Sergey1560/ble2can_hw_v2/image/ble2can_v2.png

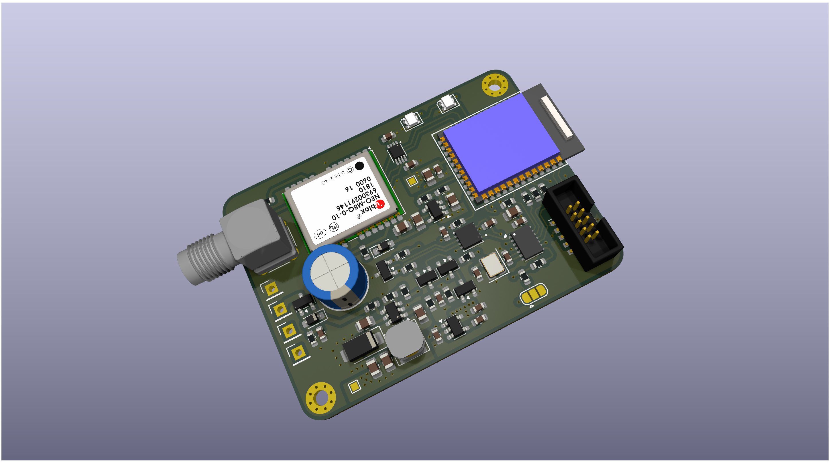
image/ble2can_v2.png
