Sergey1560/ble2can_hw_v2/image/board_size.png

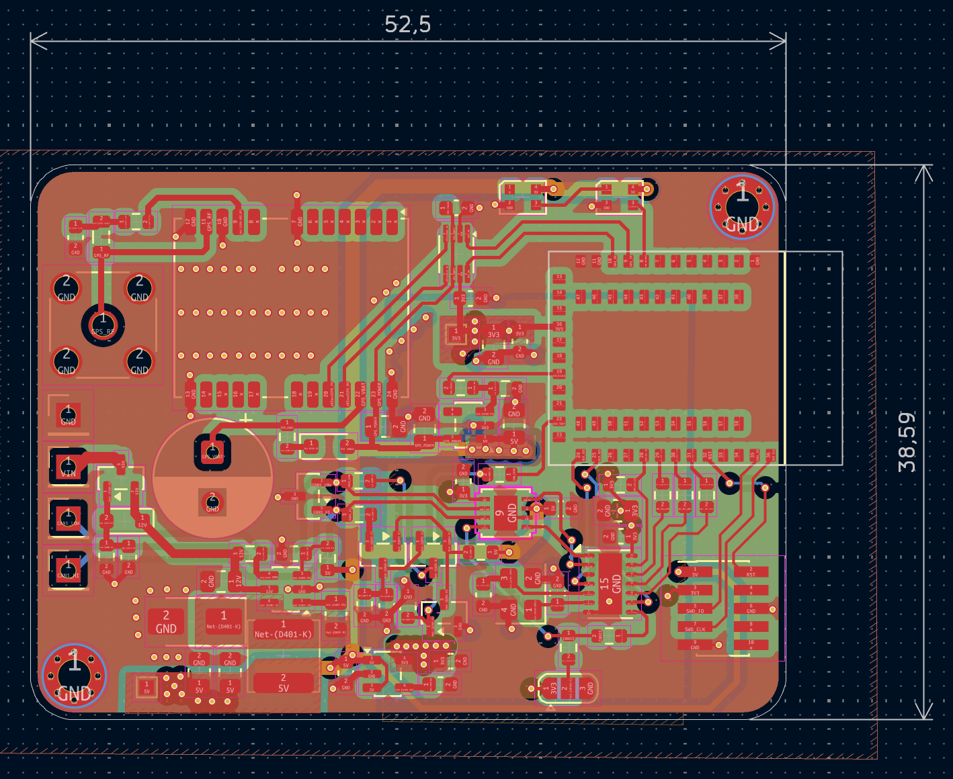
image/board_size.png
