Sergey1560/ble2can_hw_v2/3d/Led_WS2812B_2020.STEP

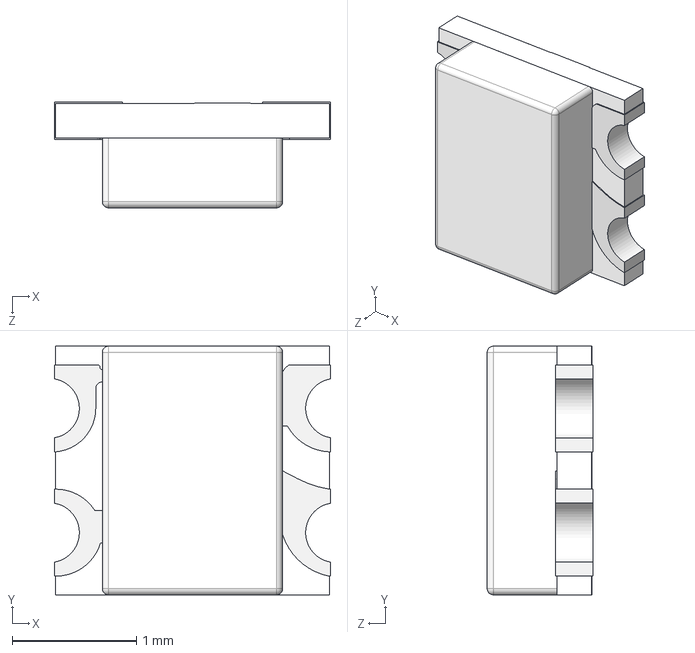
[picture p3: CAD file, 2025-12-26]
3d/Led_WS2812B_2020.STEP
2.22 x 2.00 x 0.85 mm
