Sergey1560/ble2can_hw_v2/3d/IDC2x05_SMD.STEP

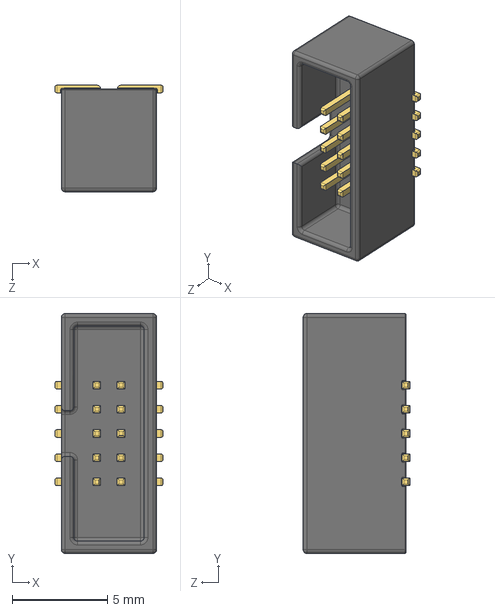
[picture p4: CAD file, 2025-12-24]
3d/IDC2x05_SMD.STEP
5.67 x 12.6 x 5.60 mm
