Sergey1560/ble2can_hw_v2/3d/SMA ANGLED.STEP

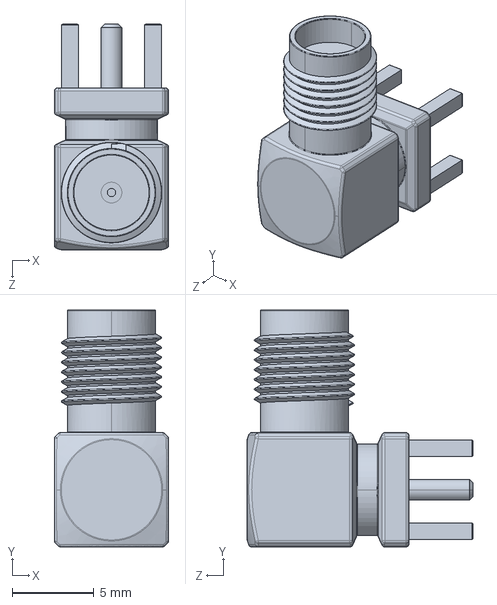
[picture p5: CAD file, 2025-12-24]
3d/SMA ANGLED.STEP
7.00 x 14.5 x 13.8 mm
