Sergey1560/ble2can_hw_v2/3d/holyiot_21069_nrf5340.STEP

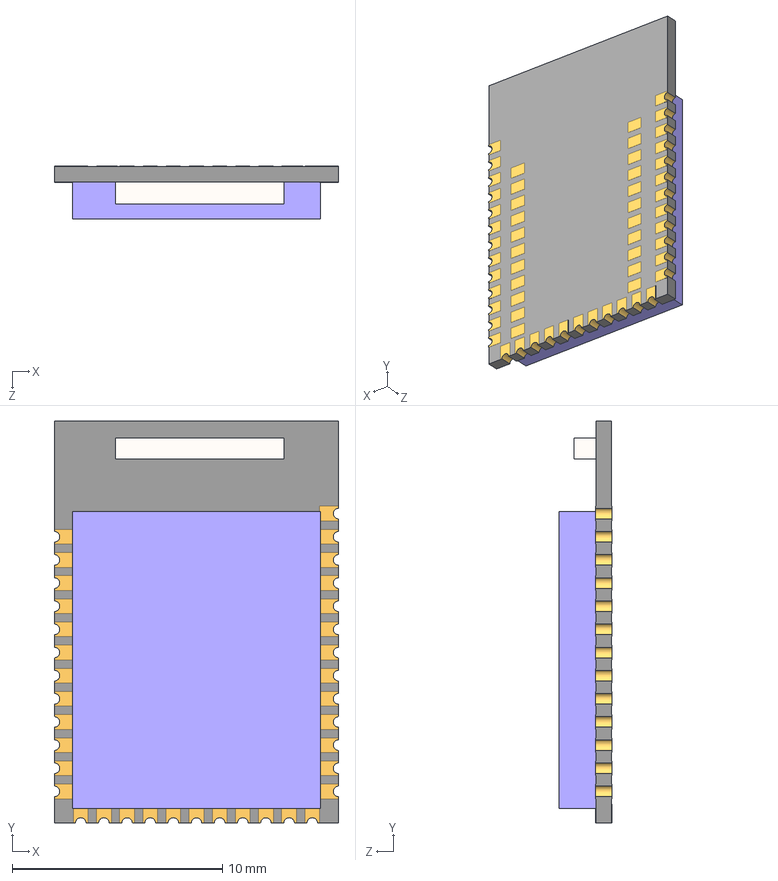
[picture p6: CAD file, 2025-08-31]
3d/holyiot_21069_nrf5340.STEP
13.5 x 19.1 x 2.51 mm
