Sergey1560/ble2can_hw_v2/rc_ble.kicad_pcb

## KiCad design rc_ble.kicad_pcb (2025-12-29)

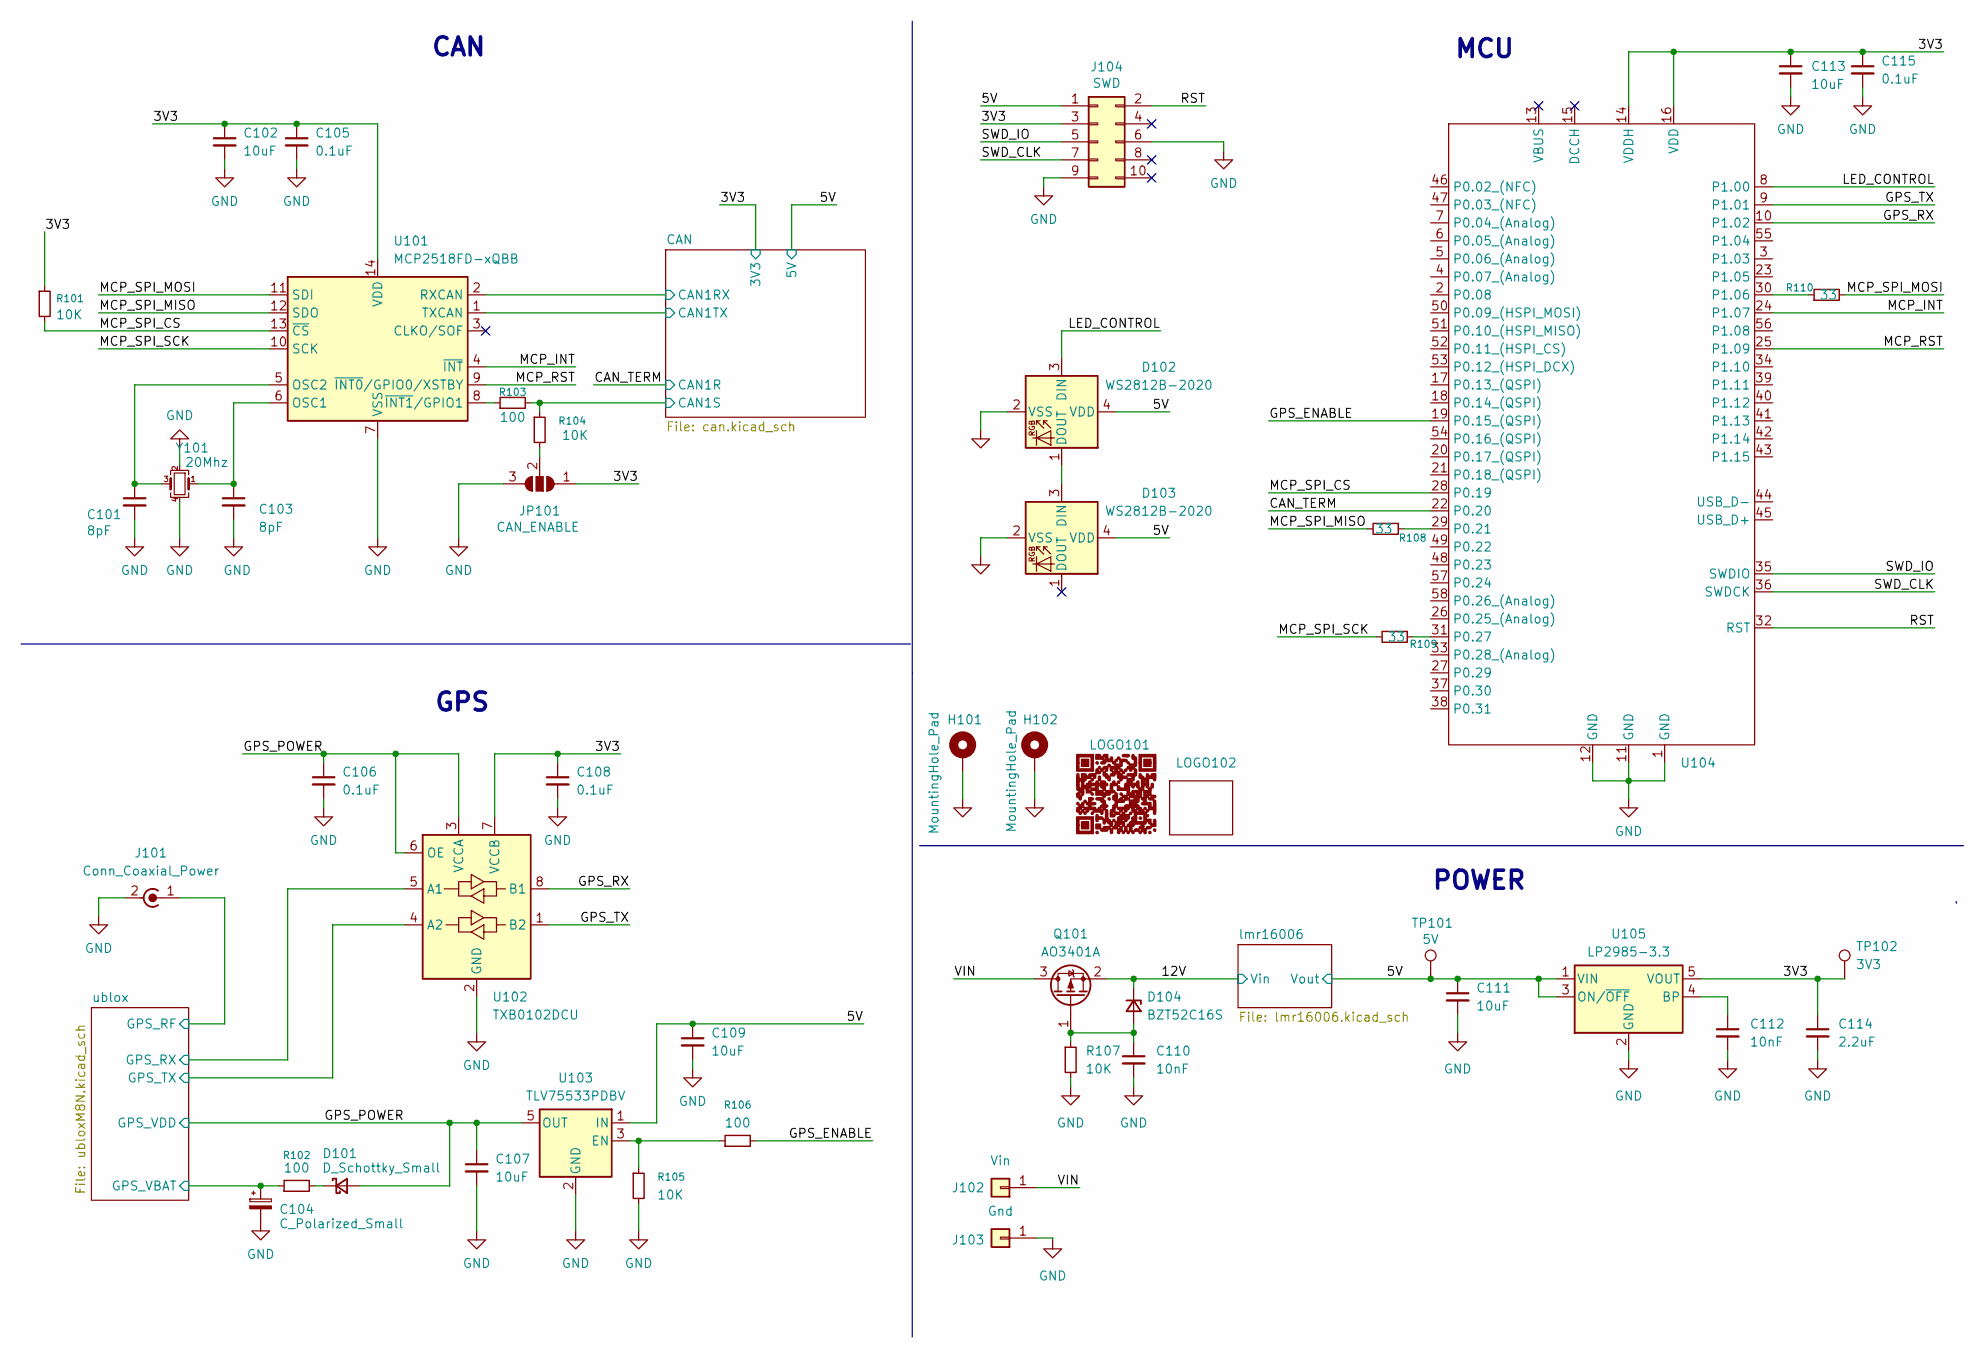
[picture p7: schematic rc_ble.kicad_sch]

Parts:
C101, C103: 8pF; C_0603_1608Metric; LCSC C38523
C102, C107, C109, C113: 10uF; C_0805_2012Metric
C104: C_Polarized_Small; CP_Radial_D8.0mm_P3.50mm
C105, C115: 0.1uF; C_0603_1608Metric
C106, C108: 0.1uF; C_0603_1608Metric; LCSC C14663
C110, C112: 10nF; C_0603_1608Metric; LCSC C57112
C111: 10uF; C_0603_1608Metric; LCSC C15849
C114: 2.2uF; C_0603_1608Metric; LCSC C23630
D101: D_Schottky_Small; D_SOD-323_HandSoldering
D102, D103: WS2812B-2020; LED_WS2812B-2020_PLCC4_2.0x2.0mm; LCSC C965555
D104: BZT52C16S; D_SOD-323_HandSoldering; LCSC C173447
H101, H102: MountingHole_Pad; MountingHole_2.2mm_M2_Pad_Via
J101: Conn_Coaxial_Power; SMA_Amphenol_132134_Vertical
J102: Vin; PinHeader_1x01_P2.54mm_Vertical
J103: Gnd; PinHeader_1x01_P2.54mm_Vertical
J104: SWD; PinHeader_2x05_P1.27mm_Vertical_SMD
JP101: CAN_ENABLE; SolderJumper-3_P1.3mm_Open_RoundedPad1.0x1.5mm
LOGO101: logo_github
LOGO102: logo_15x9
Q101: AO3401A; SOT-23; LCSC C15127
R101, R104, R105, R107: 10K; R_0603_1608Metric; LCSC C25804
R102, R103, R106: 100; R_0603_1608Metric
R108, R109, R110: 33; R_0603_1608Metric
TP101: 5V; TestPoint_Pad_1.0x1.0mm
TP102: 3V3; TestPoint_Pad_1.0x1.0mm
U101: MCP2518FD-xQBB; DFN-14-1EP_3x4.5mm_P0.65mm_EP1.65x4.25mm; LCSC C621395
U102: TXB0102DCU; VSSOP-8_2.3x2mm_P0.5mm; LCSC C60709
U103: TLV75533PDBV; SOT-23-5
U104: nrf5340
U105: LP2985-3.3; SOT-23-5; LCSC C95414
Y101: 20Mhz; Crystal_SMD_3225-4Pin_3.2x2.5mm

Connections:
/3V3: C102.1, C105.1, C108.1, C113.1, C114.1, C115.1, J104.3, JP101.1 (A), R101.1, TP102.1, U101.14 (VDD), U102.7 (VCCB), U104.14 (VDDH), U104.16 (VDD), U105.5 (VOUT); also elsewhere on the board
/5V: C109.1, C111.1, D102.4 (VDD), D103.4 (VDD), J104.1, TP101.1, U103.1 (IN), U105.1 (VIN), U105.3 (ON/~OFF); also elsewhere on the board
/12V: D104.1 (K), Q101.2 (S); also elsewhere on the board
/CAN/CAN1RX: U101.2 (RXCAN); also elsewhere on the board
/CAN/CAN1S: R103.2, R104.1; also elsewhere on the board
/CAN/CAN1TX: U101.1 (TXCAN); also elsewhere on the board
/CAN_TERM: U104.22 (P0.20); also elsewhere on the board
/GPS_ENABLE: R106.2, U104.19 (P0.15_(QSPI))
/GPS_POWER: C106.1, C107.1, D101.2 (A), U102.3 (VCCA), U102.6 (OE), U103.5 (OUT); also elsewhere on the board
/GPS_RX: U102.8 (B1), U104.10 (P1.02)
/GPS_TX: U102.1 (B2), U104.9 (P1.01)
/LED_CONTROL: D102.3 (DIN), U104.8 (P1.00)
/MCP_INT: U101.4 (~INT), U104.24 (P1.07)
/MCP_RST: U101.9 (~INT0/GPIO0/XSTBY), U104.25 (P1.09)
/MCP_SPI_CS: R101.2, U101.13 (~CS), U104.28 (P0.19)
/MCP_SPI_MISO: R108.2, U101.12 (SDO)
/MCP_SPI_MOSI: R110.2, U101.11 (SDI)
/MCP_SPI_SCK: R109.2, U101.10 (SCK)
/RST: J104.2, U104.32 (RST)
/SWD_CLK: J104.7, U104.36 (SWDCK)
/SWD_IO: J104.5, U104.35 (SWDIO)
/VIN: J102.1, Q101.3 (D)
/ublox/GPS_RF: J101.1 (In); also elsewhere on the board
/ublox/GPS_RX: U102.5 (A1); also elsewhere on the board
/ublox/GPS_TX: U102.4 (A2); also elsewhere on the board
/ublox/GPS_VBAT: C104.1, R102.1; also elsewhere on the board
GND: C101.2, C102.2, C103.2, C104.2, C105.2, C106.2, C107.2, C108.2, C109.2, C110.2, C111.2, C112.2, C113.2, C114.2, C115.2, D102.2 (VSS), D103.2 (VSS), H101.1, H102.1, J101.2 (Ext), J103.1, J104.6, J104.9, JP101.3 (B), R105.2, R107.2, U101.7 (VSS), U101.15 (VSS), U102.2 (GND), U103.2 (GND), U104.1 (GND), U104.11 (GND), U104.12 (GND), U105.2 (GND), Y101.2, Y101.4; also elsewhere on the board
unnamed: D101.1 (K), R102.2
unnamed: D102.1 (DOUT), D103.3 (DIN)
unnamed: C110.1, D104.2 (A), Q101.1 (G), R107.1
unnamed: JP101.2 (C), R104.2
unnamed: C103.1, U101.6 (OSC1), Y101.1
unnamed: C101.1, U101.5 (OSC2), Y101.3
unnamed: R103.1, U101.8 (~INT1/GPIO1)
unnamed: R105.1, R106.1, U103.3 (EN)
unnamed: R108.1, U104.29 (P0.21)
unnamed: R109.1, U104.31 (P0.27)
unnamed: R110.1, U104.30 (P1.06)
unnamed: C112.1, U105.4 (BP)

Notes on the sheet:
GPS
CAN
MCU
POWER

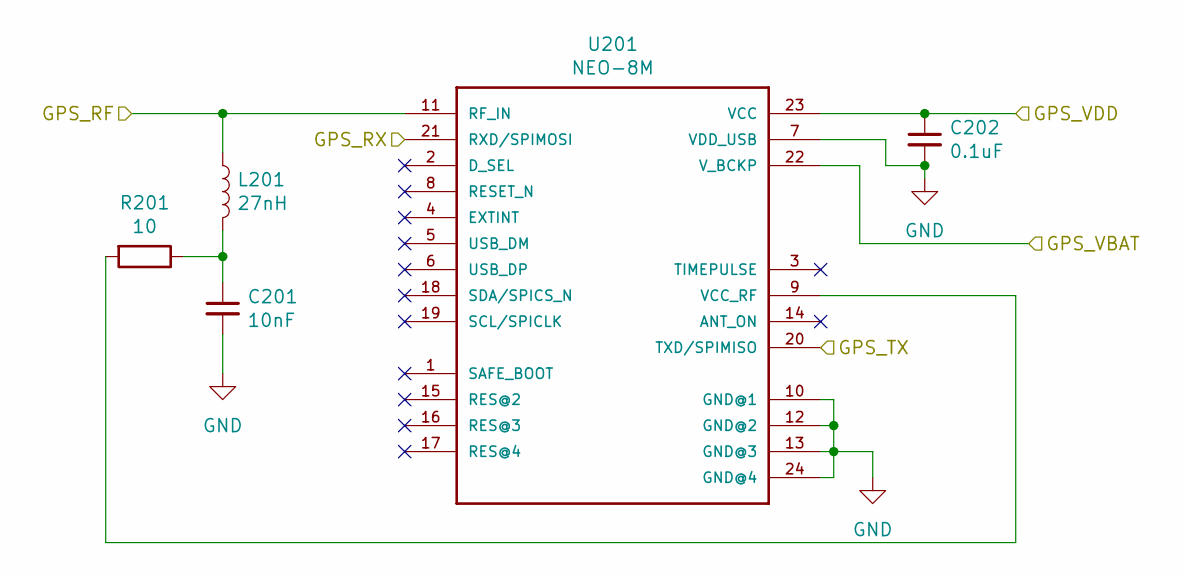
[picture p8: schematic ubloxM8N.kicad_sch, RC CAN and GPS BLE]

Parts:
C201: 10nF; C_0603_1608Metric
C202: 0.1uF; C_0805_2012Metric
L201: 27nH; L_0805_2012Metric
R201: 10; R_0603_1608Metric
U201: NEO-8M; ublox_NEO; LCSC C5119087

Connections:
/GPS_POWER: C202.1, U201.23 (VCC); also elsewhere on the board
/ublox/GPS_RF: L201.1, U201.11 (RF_IN); also elsewhere on the board
/ublox/GPS_RX: U201.21 (RXD/SPIMOSI); also elsewhere on the board
/ublox/GPS_TX: U201.20 (TXD/SPIMISO); also elsewhere on the board
/ublox/GPS_VBAT: U201.22 (V_BCKP); also elsewhere on the board
GND: C201.2, C202.2, U201.7 (VDD_USB), U201.10 (GND@1), U201.12 (GND@2), U201.13 (GND@3), U201.24 (GND@4); also elsewhere on the board
unnamed: C201.1, L201.2, R201.1
unnamed: R201.2, U201.9 (VCC_RF)

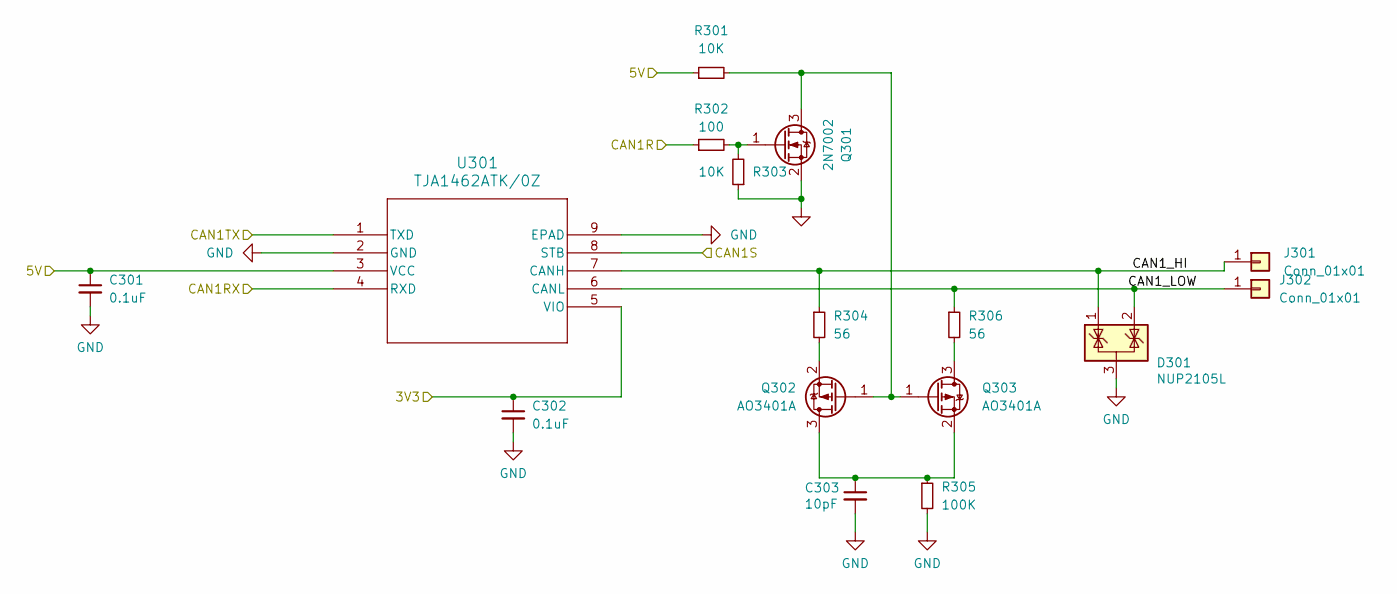
[picture p9: schematic can.kicad_sch, CAN BUS]

Parts:
C301, C302: 0.1uF; C_0603_1608Metric; LCSC C14663
C303: 10pF; C_0603_1608Metric; LCSC C1669
D301: NUP2105L; SOT-23; LCSC C284104
J301, J302: Conn_01x01; PinHeader_1x01_P2.54mm_Vertical
Q301: 2N7002; SOT-23; LCSC C8545
Q302, Q303: AO3401A; SOT-23; LCSC C15127
R301, R303: 10K; R_0603_1608Metric; LCSC C25804
R302: 100; R_0603_1608Metric; LCSC C22775
R304, R306: 56; R_0603_1608Metric; LCSC C25196
R305: 100K; R_0603_1608Metric; LCSC C25803
U301: TJA1462ATK/0Z; HVSON8_TJA1462_NXP; LCSC C3229259

Connections:
/3V3: C302.1, U301.5 (VIO); also elsewhere on the board
/5V: C301.1, R301.1, U301.3 (VCC); also elsewhere on the board
/CAN/CAN1RX: U301.4 (RXD); also elsewhere on the board
/CAN/CAN1S: U301.8 (STB); also elsewhere on the board
/CAN/CAN1TX: U301.1 (TXD); also elsewhere on the board
/CAN/CAN1_HI: D301.1 (K), J301.1, R304.1, U301.7 (CANH)
/CAN/CAN1_LOW: D301.2 (K), J302.1, R306.1, U301.6 (CANL)
/CAN_TERM: R302.1; also elsewhere on the board
GND: C301.2, C302.2, C303.2, D301.3 (A), Q301.2 (S), R303.1, R305.2, U301.2 (GND), U301.9 (EPAD); also elsewhere on the board
unnamed: Q301.3 (D), Q302.1 (G), Q303.1 (G), R301.2
unnamed: Q301.1 (G), R302.2, R303.2
unnamed: C303.1, Q302.3 (D), Q303.2 (S), R305.1
unnamed: Q302.2 (S), R304.2
unnamed: Q303.3 (D), R306.2

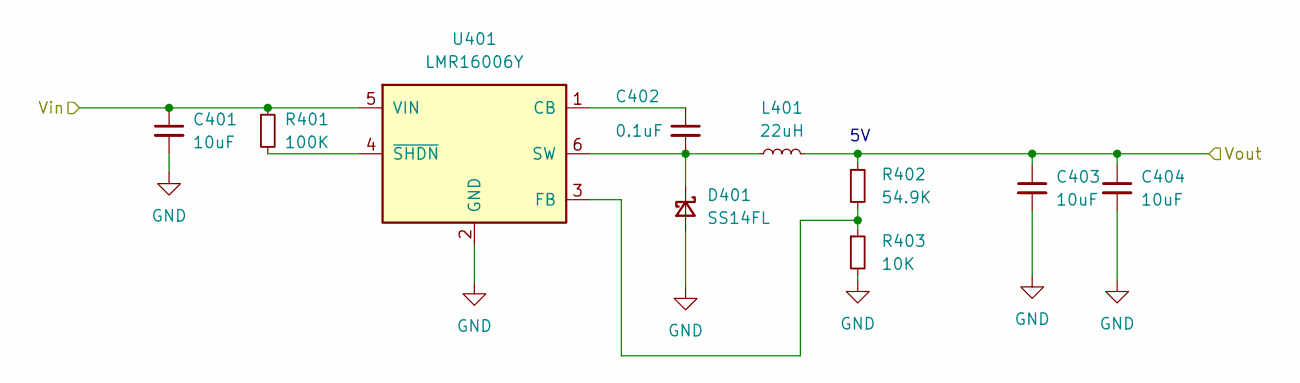
[picture p10: schematic lmr16006.kicad_sch, DC-DC]

Parts:
C401, C403, C404: 10uF; C_0805_2012Metric; LCSC C440198
C402: 0.1uF; C_0805_2012Metric; LCSC C28233
D401: SS14FL; D_SMA; LCSC C111580
L401: 22uH; FNR5040S220MT; LCSC C167971
R401: 100K; R_0603_1608Metric; LCSC C25803
R402: 54.9K; R_0603_1608Metric; LCSC C728593
R403: 10K; R_0603_1608Metric; LCSC C25804
U401: LMR16006Y; SOT-23-6; LCSC C290195

Connections:
/5V: C403.1, C404.1, L401.2, R402.1; also elsewhere on the board
/12V: C401.1, R401.1, U401.5 (VIN); also elsewhere on the board
GND: C401.2, C403.2, C404.2, D401.2 (A), R403.2, U401.2 (GND); also elsewhere on the board
unnamed: C402.2, D401.1 (K), L401.1, U401.6 (SW)
unnamed: C402.1, U401.1 (CB)
unnamed: R402.2, R403.1, U401.3 (FB)
unnamed: R401.2, U401.4 (~SHDN)

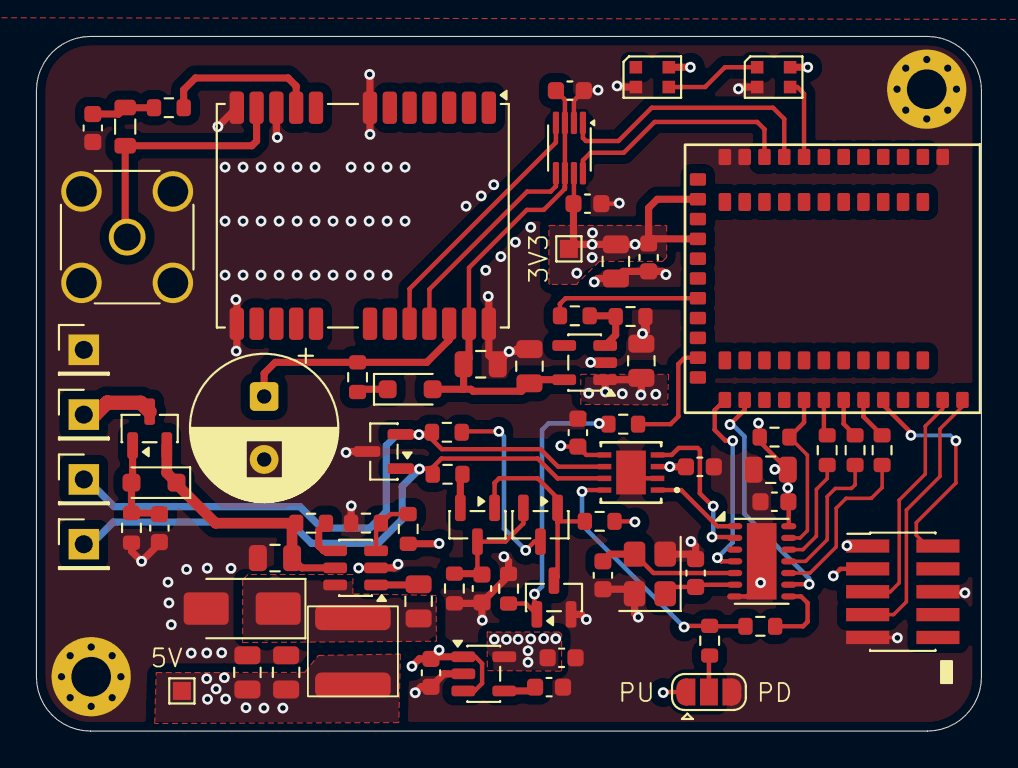
[picture p11: board rc_ble.kicad_pcb from above]

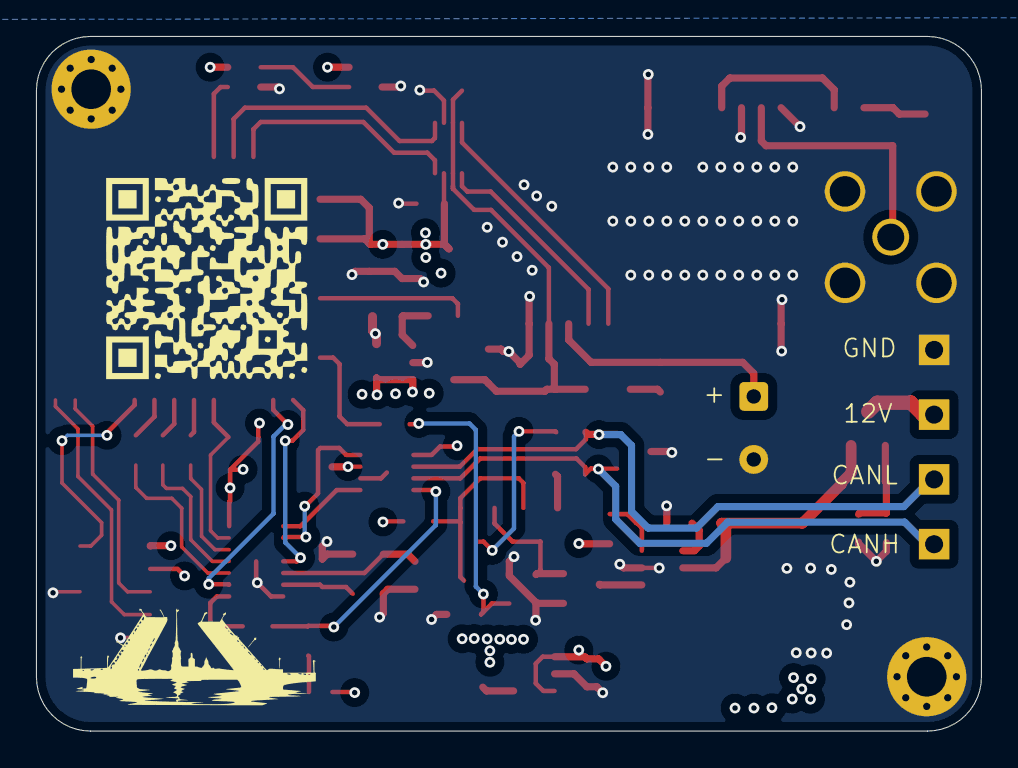
[picture p12: board rc_ble.kicad_pcb from below]

Board: 4 copper layers, 52.5 x 38.6 mm, 78 parts (2 on the bottom side), 52 nets.
