Sergey1560/ble2can_hw_v2/(commit log)

2025-08-31 holyiot module
    [holyiot_21069_nrf5340.STEP, rc_ble.kicad_pcb, rc_ble.kicad_sch]
2025-12-26 redesing board
    [Led_WS2812B_2020.STEP, can.kicad_sch, lmr16006.kicad_sch, rc_ble.kicad_pcb, rc_ble.kicad_sch, ubloxM8N.kicad_sch]
2025-12-29 VDDH pin
    [rc_ble.kicad_pcb, rc_ble.kicad_sch]
2025-12-29 PCBA ready
    [BOM-rc_ble.csv, can.kicad_sch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]
